nkh5/joint_effort/JointEffort-ROS2-V0/ros/docs/README.md

# Project notes

- [Setup](SETUP.md): install, build, and start the workspace.
- [Code](CODE.md): extra info.
- [Files](FILES.md): every file included in the folder. 

The [iron-arm guide](../iron_prototype/README.md) has the movement commands.
