nkh5/joint_effort/CAD/Gearboxes/Cycloidal/20-1 Micro Cycloidal BOM.csv

Part Name | Part URL | Part Cost (Per Unit) | Units Required | Required Part Total | Cost Per Pack
30*37*4mm Bearings | https://www.aliexpress.com/item/4000909605390.html | $2.64 | 2 | $5.28 | $13.20
7*13*4mm Bearings | https://www.aliexpress.com/item/1005004909186623.html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 | $2.02 | 2 | $4.04 | $20.19
8*12*3.5mm Bearings | https://www.aliexpress.com/item/1005006896182452.html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 | $1.03 | 2 | $2.06 | $10.30
M3*20mm Button Head Bolts | https://www.aliexpress.com/item/1005008064515476.html?curPageLogUid=Z8iONcXzmQOj | $0.11 | 6 | $0.64 | $2.12
M3*8mm Countersunk Bolts | https://www.aliexpress.com/item/1005006468976904.html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 | $0.05 | 4 | $0.18 | $2.25
M3 Nuts | https://www.aliexpress.com/item/1005007694230467.html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 | $0.05 | 6 | $0.28 | $2.36
M3*5mm*10mm Aluminium Rollers | https://www.aliexpress.com/item/1005005962614409.html | $0.23 | 6 | $1.41 | $4.69
 |  |  | Total Parts | Required Costs | Package Costs: (Makes 2+ Drives)
 |  |  | 28 | $13.88 | $55.11
