nkh5/joint_effort/CAD/Gearboxes/Harmonic/26-1 Micro Harmonic BOM.csv

Part Name | Part URL | Part Cost (Per Unit) | Units Required | Required Part Total | Cost Per Pack
30*37*4mm Bearings 2RS | https://www.aliexpress.com/item/4000909605390.html | $2.64 | 2 | $5.28 | $13.20
7*13*4mm Bearings 2RS | https://www.aliexpress.com/item/1005004909186623.html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 | $2.02 | 2 | $4.04 | $20.19
M3*12mm Countersunk Bolts | https://www.aliexpress.com/item/1005006468976904.html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 | $0.05 | 4 | $0.20 | $2.46
5mm Balls | https://www.aliexpress.com/item/1005005656499702.html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 | $0.04 | 14 | $0.56 | $2.01
M3*4.5mm*6mm (OD*Length) | https://www.aliexpress.com/item/1005003582355741.html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 | $0.11 | 6 | $0.65 | $3.23
 |  |  | Total Parts | Required Costs | Package Costs: (Makes 2+ Drives)
 |  |  | 28 | $10.72 | $41.09
