nkh5/joint_effort/CAD/Gearboxes/Cycloidal/Print-Ready Orientation/Flex Spline 0.05mm.stl

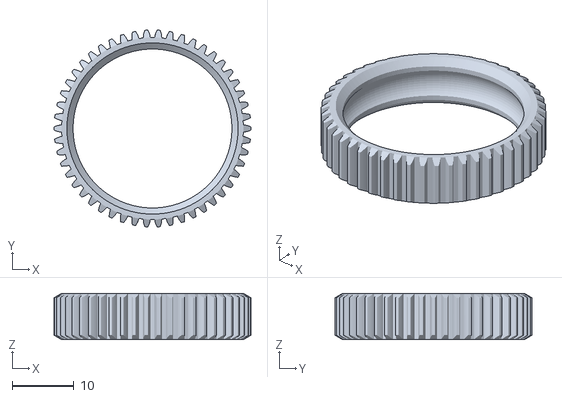
[picture p1: CAD file, 2026-11-12]
CAD/Gearboxes/Cycloidal/Print-Ready Orientation/Flex Spline 0.05mm.stl
32.0 x 32.0 x 7.50
