nkh5/joint_effort/JointEffort-Physical-Tests/ros2_ws/src/joint_effort_iron/meshes/base_rotation_link_hull.stl

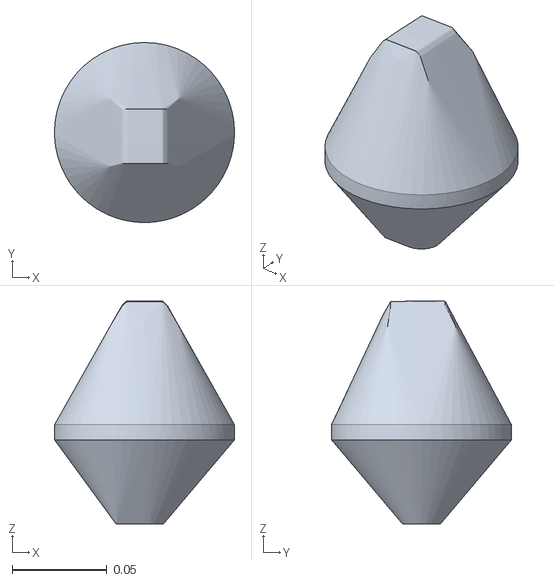
[picture p2: CAD file, 2026-10-19]
JointEffort-Physical-Tests/ros2_ws/src/joint_effort_iron/meshes/base_rotation_link_hull.stl
0.095 x 0.095 x 0.118
