nkh5/joint_effort/JointEffort-ROS2-V0/ros/ros2_ws/src/joint_effort_arm_draft_description/meshes/base_rotation_link.stl

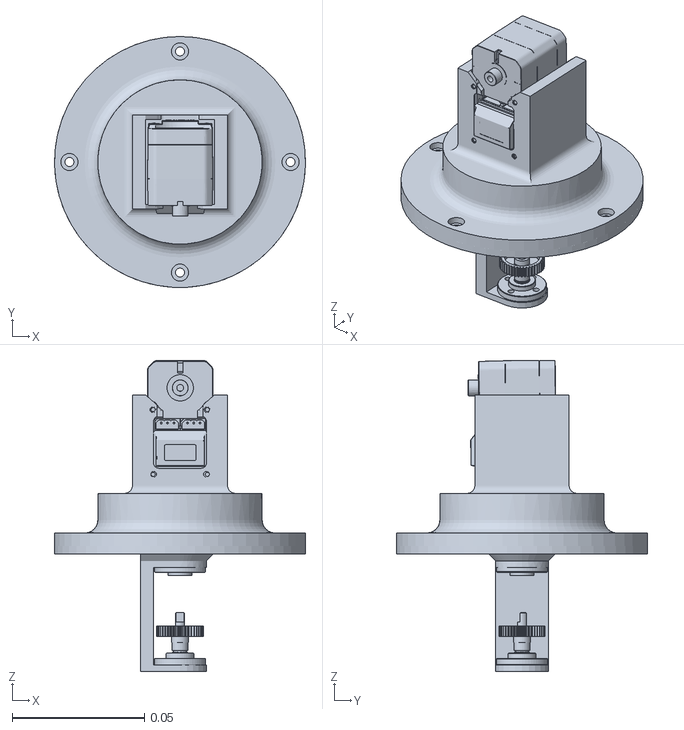
[picture p3: CAD file, 2026-10-17]
JointEffort-ROS2-V0/ros/ros2_ws/src/joint_effort_arm_draft_description/meshes/base_rotation_link.stl
0.095 x 0.095 x 0.118
