nkh5/joint_effort/JointEffort-ROS2-V0/ros/ros2_ws/src/joint_effort_iron/meshes/upper_arm_link_hull.stl

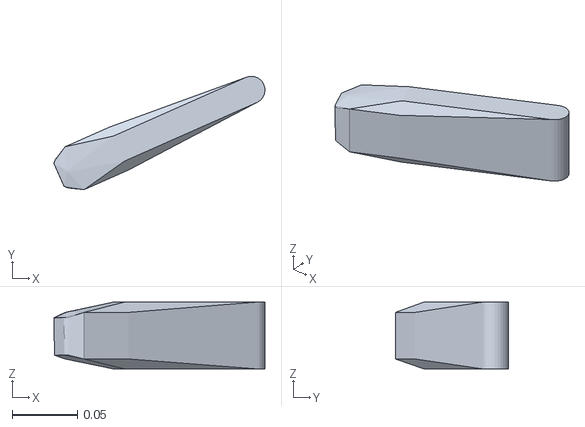
[picture p4: CAD file, 2026-10-17]
JointEffort-ROS2-V0/ros/ros2_ws/src/joint_effort_iron/meshes/upper_arm_link_hull.stl
0.162 x 0.087 x 0.0512
