nkh5/joint_effort/CAD/Gearboxes/Harmonic/Print-Ready Orientation/Flex Spline 0.15mm.stl

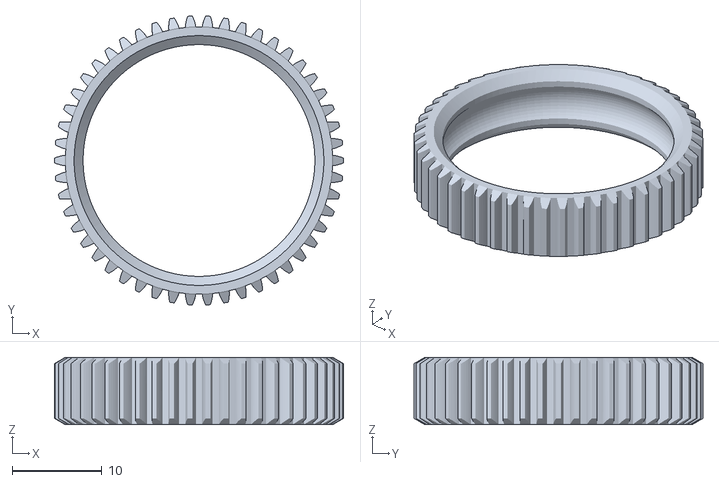
[picture p5: CAD file, 2026-11-12]
CAD/Gearboxes/Harmonic/Print-Ready Orientation/Flex Spline 0.15mm.stl
32.2 x 32.2 x 7.50
