nkh5/joint_effort/JointEffort-Physical-Tests/ros2_ws/src/joint_effort_iron/meshes/base_link_hull.stl

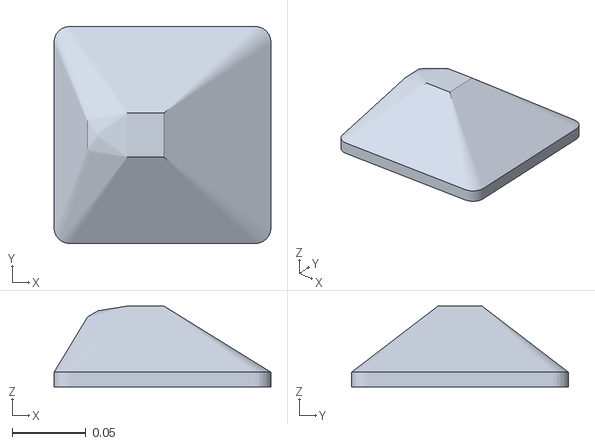
[picture p6: CAD file, 2026-10-19]
JointEffort-Physical-Tests/ros2_ws/src/joint_effort_iron/meshes/base_link_hull.stl
0.148 x 0.148 x 0.055
