nkh5/joint_effort/JointEffort-ROS2-V0/ros/ros2_ws/src/joint_effort_arm_draft_description/meshes/base_link.stl

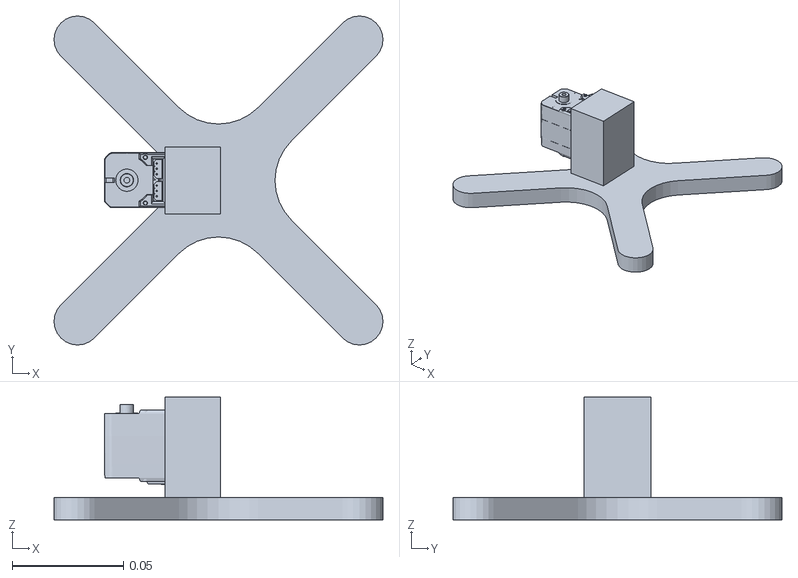
[picture p7: CAD file, 2026-10-17]
JointEffort-ROS2-V0/ros/ros2_ws/src/joint_effort_arm_draft_description/meshes/base_link.stl
0.148 x 0.148 x 0.055
