nkh5/joint_effort/CAD/Gearboxes/Harmonic/Print-Ready Orientation/Output.stl

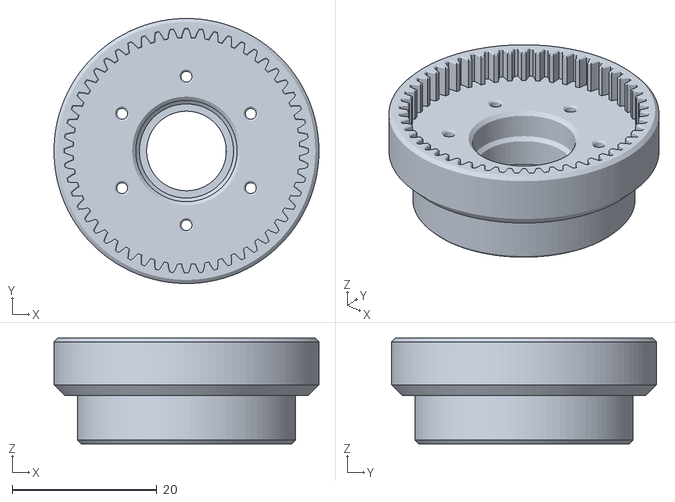
[picture p8: CAD file, 2026-11-12]
CAD/Gearboxes/Harmonic/Print-Ready Orientation/Output.stl
36.6 x 36.6 x 14.6
