nkh5/joint_effort/JointEffort-Physical-Tests/ros2_ws/src/joint_effort_iron/meshes/tool_link_hull.stl

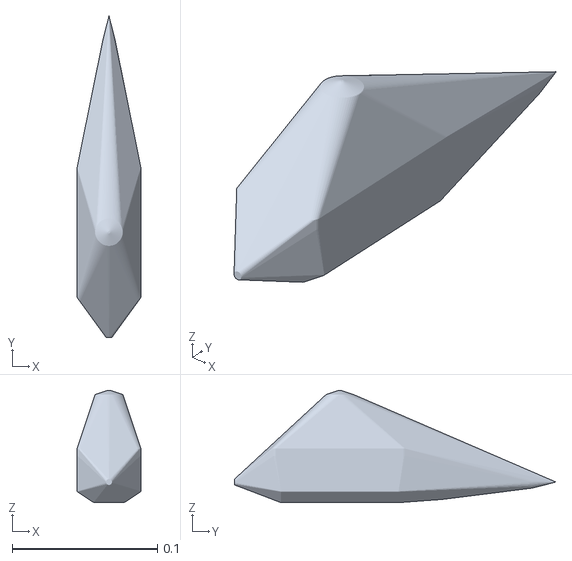
[picture p9: CAD file, 2026-10-19]
JointEffort-Physical-Tests/ros2_ws/src/joint_effort_iron/meshes/tool_link_hull.stl
0.044 x 0.221 x 0.0773
