nkh5/joint_effort/JointEffort-ROS2-V0/ros/ros2_ws/src/joint_effort_arm_draft_description/meshes/forearm_link.stl

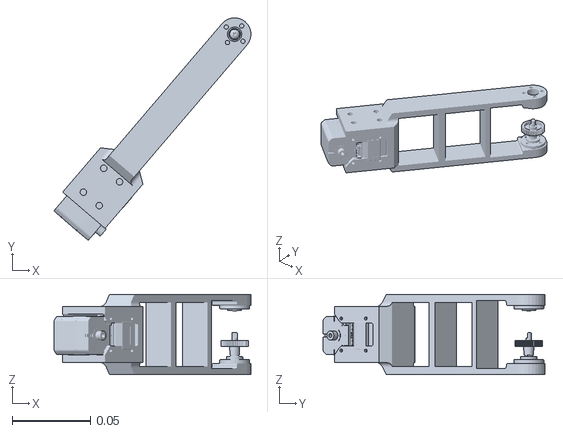
[picture p11: CAD file, 2026-10-17]
JointEffort-ROS2-V0/ros/ros2_ws/src/joint_effort_arm_draft_description/meshes/forearm_link.stl
0.126 x 0.142 x 0.0512
