nkh5/joint_effort/CAD/Gearboxes/Harmonic/Print-Ready Orientation/Shaft.stl

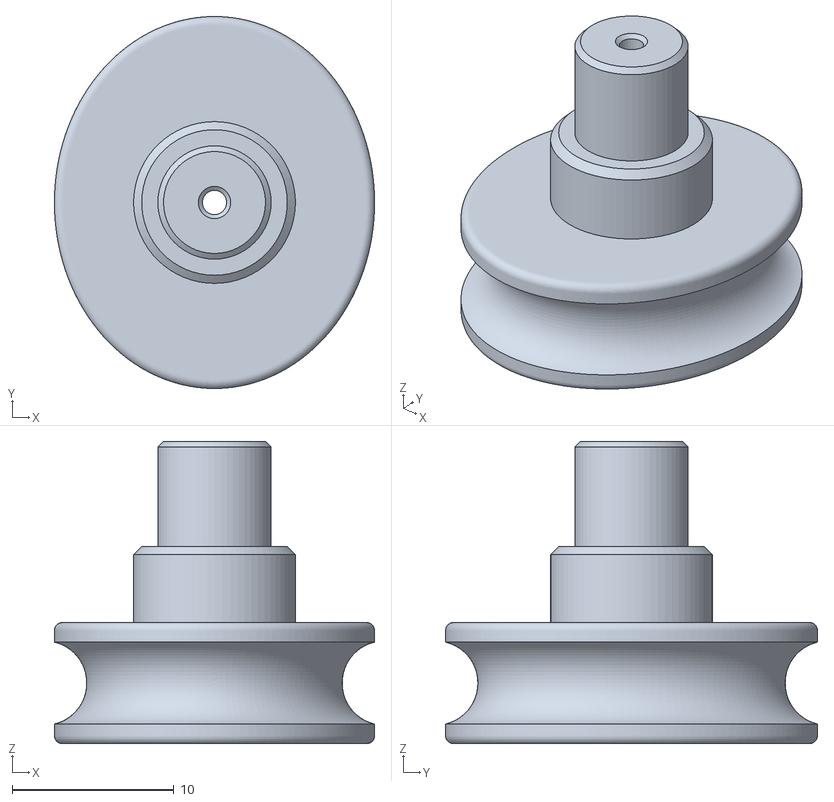
[picture p12: CAD file, 2026-11-12]
CAD/Gearboxes/Harmonic/Print-Ready Orientation/Shaft.stl
19.8 x 23.0 x 18.7
