nkh5/joint_effort/CAD/Gearboxes/Harmonic/Print-Ready Orientation/Housing.stl

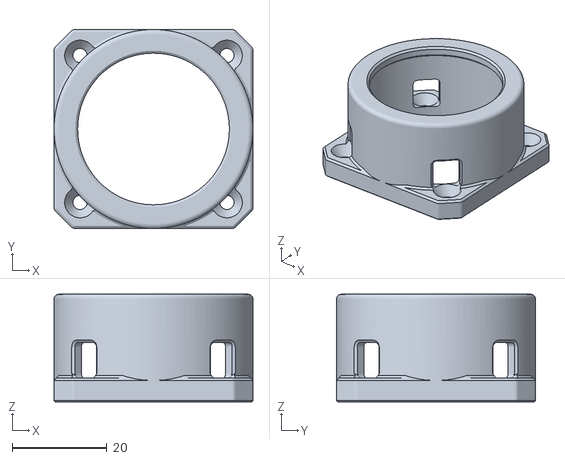
[picture p13: CAD file, 2026-11-12]
CAD/Gearboxes/Harmonic/Print-Ready Orientation/Housing.stl
42.0 x 42.0 x 22.7
