nkh5/joint_effort/CAD/Gearboxes/Harmonic/Print-Ready Orientation/Base - Nema 17.stl

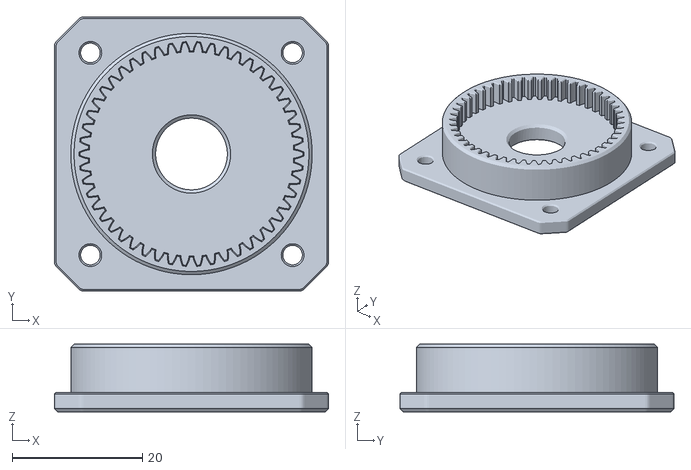
[picture p14: CAD file, 2026-11-12]
CAD/Gearboxes/Harmonic/Print-Ready Orientation/Base - Nema 17.stl
42.0 x 42.0 x 10.4
