nkh5/joint_effort/(list of files, cad)

Other CAD files:
CAD/Solder Extruder/Extruder Assembly.SLDASM
CAD/Solder Extruder/V2/Extruder Assembly_V2.SLDASM
CAD/V2.1/PSJv1.SLDASM
CAD/V2.1/joint stack arm v2/jointstack.SLDASM
CAD/V2.1/psj mechanism v2/PSJv2.SLDASM
CAD/Calibration/CalibrationAssembly.SLDASM
CAD/Solder Extruder/Guide Assembly.SLDASM
CAD/Solder Extruder/V2/Parts/Guide Assembly_V2.SLDASM
CAD/Calibration/Motor Holder.SLDPRT
CAD/Gearboxes/Harmonic/Print-Ready Orientation/Flex Spline 0.00mm.stl
CAD/Solder Extruder/Extruder Parts/Frame V1.2.SLDPRT
CAD/V2.1/psj mechanism v2/ToolHolderv2^PSJv2.SLDPRT
CAD/Calibration/Calibration Stick.SLDPRT
CAD/Gearboxes/Cycloidal/Print-Ready Orientation/Flex Spline 0.10mm.stl
CAD/Solder Extruder/Extruder Parts/Extruder Funnel V2.SLDPRT
CAD/Solder Extruder/Frame V1.1.SLDPRT
CAD/Solder Extruder/V2/Parts/Extruder Cover_V3.SLDPRT
CAD/Gearboxes/Cycloidal/Print-Ready Orientation/Flex Spline 0.25mm.stl
CAD/Solder Extruder/Extruder Parts/Stepper Motor 28BYJ-48.SLDPRT
CAD/Solder Extruder/Intake Funnel V2.SLDPRT
CAD/Solder Extruder/V2/Parts/Frame V1.2_V2.SLDPRT
CAD/V2.1/psj mechanism v2/editable_linkage2_bar1v1.SLDPRT
CAD/Gearboxes/Harmonic/Print-Ready Orientation/Flex Spline 0.20mm.stl
CAD/Solder Extruder/Extruder Funnel V2.SLDPRT
CAD/Solder Extruder/V2/Parts/Spring_V2.SLDPRT
CAD/V2.1/psj mechanism v2/editable_linkage2_bar2v1.SLDPRT
CAD/Solder Extruder/V2/Parts/Intake Funnel V2_V2.SLDPRT
CAD/V2.1/psj mechanism v2/editable_linkage3_bar2v1.SLDPRT
CAD/Solder Extruder/Extruder Guide Wheel.SLDPRT
CAD/Solder Extruder/V2/Parts/Extruder Gear_V2.SLDPRT
CAD/V2.1/psj mechanism v2/editable_linkage1_bar1v1.SLDPRT
CAD/V2.1/psj mechanism v2/editable_linkage3_bar1v1.SLDPRT
CAD/Solder Extruder/V2/Parts/Extruder Guide Frame_V2.SLDPRT
CAD/V2.1/psj mechanism v2/Solder_holder_clamp^PSJv2.SLDPRT
CAD/V2.1/psj mechanism v2/editable_linkage1_bar2v1.SLDPRT
CAD/V2.1/psj mechanism v2/editable_linkagev1.SLDPRT
CAD/Solder Extruder/Extruder Funnel.SLDPRT
CAD/Solder Extruder/V1/Extruder Assembly.SLDASM
CAD/Solder Extruder/V1/Extruder Parts/Extruder Funnel.SLDPRT
CAD/Solder Extruder/V1/Extruder Parts/Frame V1.1.SLDPRT
CAD/Solder Extruder/V1/Extruder Parts/Frame V1.2.SLDPRT
CAD/Solder Extruder/V2/Parts/Extruder Cover_V2.SLDPRT
CAD/V1.1/Base/Base Assembly V1.1.SLDASM
CAD/V1.1/Base/Base Motor Mount.SLDPRT
CAD/V1.1/Base/Base Rotating Part.SLDPRT
CAD/V1.1/Base/Fixed Base.SLDPRT
CAD/V1.1/Base/OLD Rotating Base.SLDPRT
CAD/V1.1/Base/Rotating Base.SLDPRT
CAD/V1.1/Elbow/Elbow Assembly V1.1.SLDASM
CAD/V1.1/Elbow/elbow joint.SLDASM
CAD/V1.1/Elbow/linkage_l1.SLDPRT
CAD/V1.1/Elbow/linkage_l2.SLDPRT
CAD/V1.1/Elbow/motormount_baseattachment.SLDPRT
CAD/V1.1/Full Assembly V1.1.SLDASM
CAD/V1.1/Iron Holder/Iron Holder Assembly V1.1.SLDASM
CAD/V1.1/Iron Holder/JE-ColdFit-Cap-R01.SLDPRT
CAD/V1.1/Iron Holder/JE-ColdFit-LowerSaddle-R01.SLDPRT
CAD/V1.1/Iron Holder/JE-ColdFit-Spine-R01.SLDPRT
CAD/V1.1/Wrist/Wrist Assembly V1.1.SLDASM
CAD/V1.1/Wrist/pitch_holder^wrist_v1.SLDPRT
CAD/V1.1/Wrist/yaw_mount^wrist_v1.SLDPRT
CAD/V1.2/R02-base_link.SLDPRT
CAD/V1.2/R02-base_rotation_link.SLDPRT
CAD/V1.2/R02-forearm_link.SLDPRT
CAD/V1.2/R02-tool_link.SLDPRT
CAD/V1.2/R02-upper_arm_link.SLDPRT
CAD/V1.2/R02-wrist_link.SLDPRT
CAD/V2.1/joint stack arm v2/8920N27_Light Duty Dry-Running Thrust Bearing.SLDPRT
CAD/V2.1/joint stack arm v2/92000A326_Passivated 18-8 Stainless Steel Pan Head Phillips Screws.SLDPRT
CAD/V2.1/psj mechanism v1/Linkage1^PSJv1.SLDPRT
CAD/V2.1/psj mechanism v1/Linkage1bar1v2^PSJv1.SLDPRT
CAD/V2.1/psj mechanism v1/Linkage1bar2v2^PSJv1.SLDPRT
CAD/V2.1/psj mechanism v1/Linkage2bar1v1^PSJv1.SLDPRT
CAD/V2.1/psj mechanism v1/Linkage2bar2v1^PSJv1.SLDPRT
CAD/V2.1/psj mechanism v1/Linkage2v2^PSJv1.SLDPRT
CAD/V2.1/psj mechanism v1/Linkage3bar1v1^PSJv1.SLDPRT
CAD/V2.1/psj mechanism v1/Linkage3bar2v1^PSJv1.SLDPRT
CAD/V2.1/psj mechanism v1/PSJv1.SLDASM
