nkh5/joint_effort/CAD/Gearboxes/Cycloidal/20-1 Micro Cycloidal Instructions.pdf

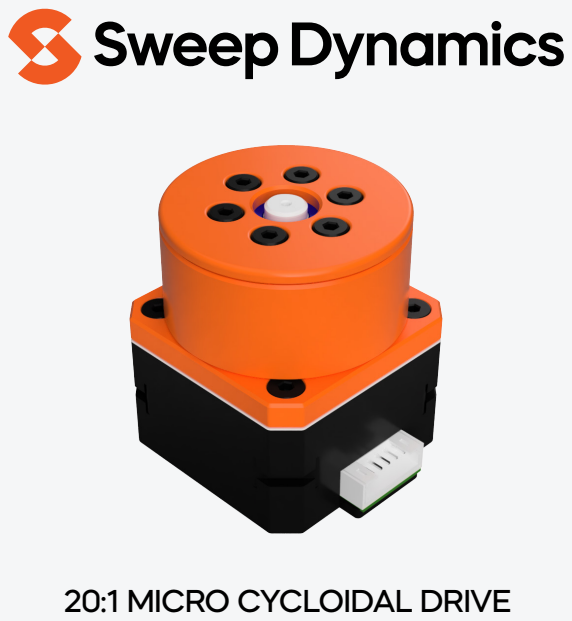
[picture p15: page 1]

20:1 MICRO CYCLOIDAL DRIVE

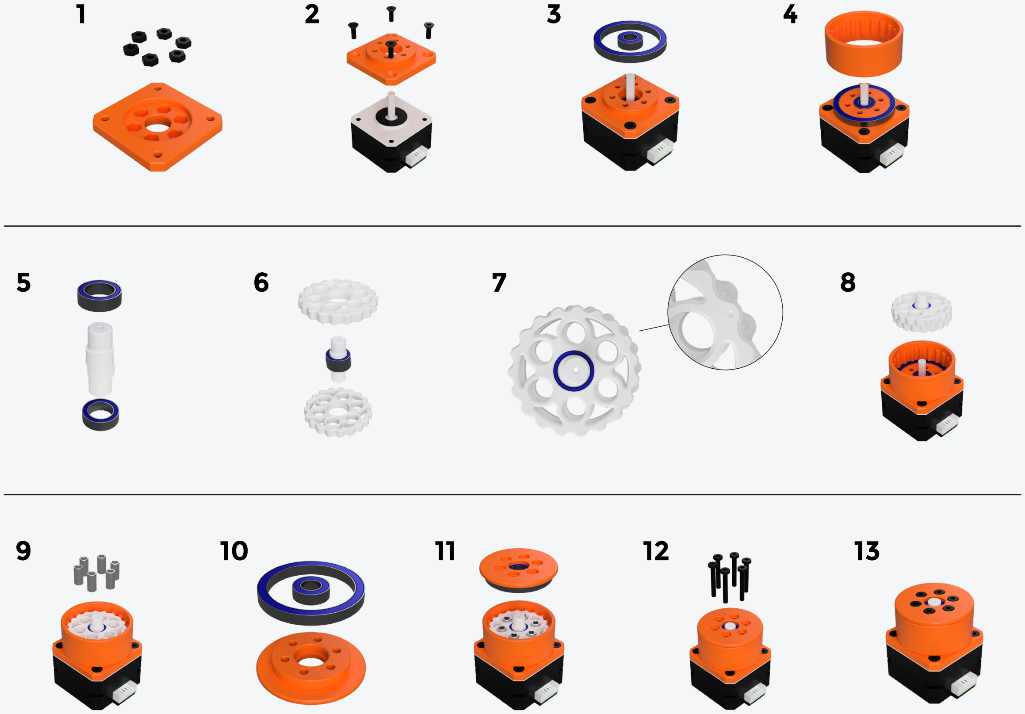
[picture p16: page 2]

1 | 2 | 3 | 4

5

9 | 10 | 11 | 12 | 13
6 | 7 | 8
