nkh5/joint_effort/CAD/Gearboxes/Harmonic/26-1 Micro Harmonic Instructions.pdf

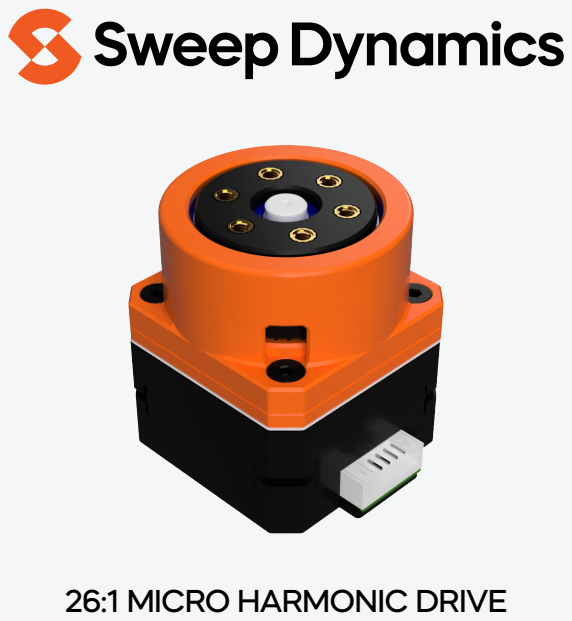
[picture p17: page 1]

26:1 MICRO HARMONIC DRIVE

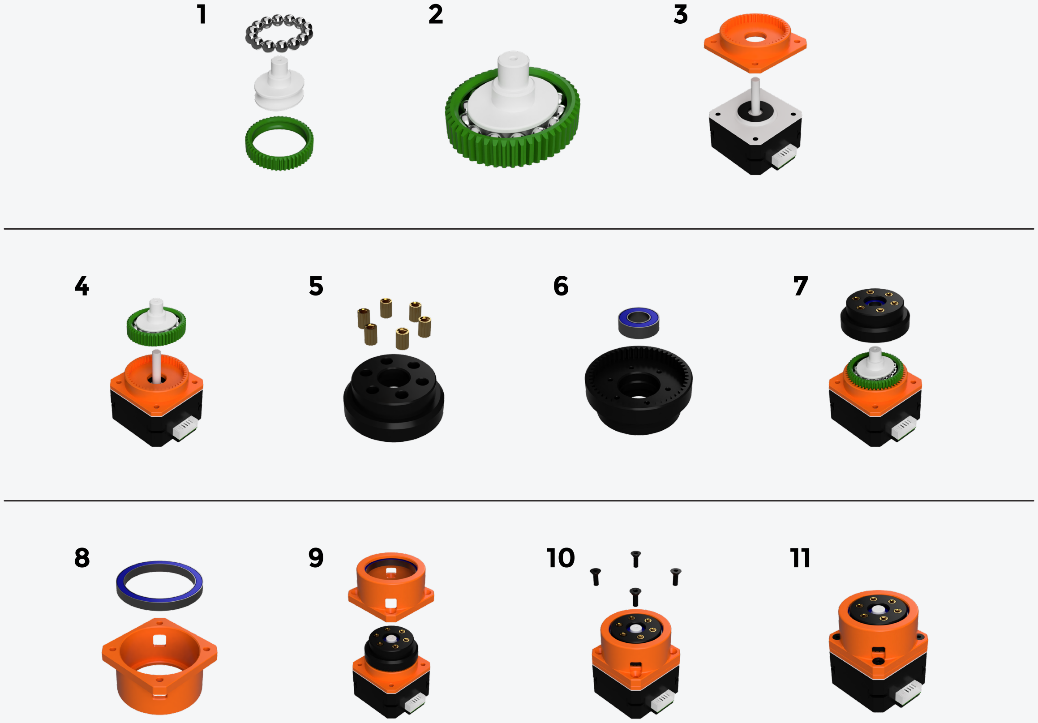
[picture p18: page 2]

1 | 2 | 3

4 5

9 | 10 | 11

6 7

8
