nkh5/joint_effort/(commit log)

2026-10-06 1st iteration of pico controller code following tinyusb
2026-10-07 Create CAD
    Folder to commit CAD
2026-10-07 Add CAD Git LFS workflow
2026-10-07 CAD V1.1
    Uploaded the first full assembly of the arm
    [Base Assembly V1.1.SLDASM, Elbow Assembly V1.1.SLDASM, Fixed Base.SLDPRT, Full Assembly V1.1.SLDASM, Iron Holder Assembly V1.1.SLDASM, JE-ColdFit-Cap-R01.SLDPRT, JE-ColdFit-LowerSaddle-R01.SLDPRT, JE-ColdFit-Spine-R01.SLDPRT]
2026-10-08 editing pitch holder
    [pitch_holder^wrist_v1.SLDPRT]
2026-10-08 yaw mount edit
    [yaw_mount^wrist_v1.SLDPRT]
2026-10-15 updated shoulder
    updated shoulder base to prevent bolt interference
2026-10-17 removed uncessary holes
2026-10-19 Add physical arm motor tests
2026-10-19 Permanent id and 3 motors
2026-10-20 Create Frame V1.1.SLDPRT
2026-10-23 Create Stepper Motor 28BYJ-48.SLDPRT
2026-10-23 updated extruder mechanism
2026-10-23 Worked on extrusion
2026-10-24 Add interactive MATLAB function for 3-RRR mechanism
    This file implements an interactive MATLAB function for a nominal spherical 3-RRR mechanism, allowing users to visualize and manipulate the mechanism's configuration through sliders for pitch, yaw, and roll.
2026-10-24 added v2.1 prelim joint stack
2026-10-24 Lots of updates to extruder assembly
2026-10-27 made calibration and worked extruder
2026-10-27 updated extruder
2026-10-27 linkage mechanism (no bearings)
2026-10-27 bearing holes added
    top part isn't flat, so need to fix linkages still
2026-10-28 Update Extruder Assembly.SLDASM
2026-10-28 updated extruder funnel
2026-10-28 created new extruder base plate to tweak tension
2026-11-03 Update Frame V1.2.SLDPRT
2026-11-05 fix hole sizes for linkage
    Pepper make me sad
2026-11-05 Add aligned arm CAD under CAD/V1.2 with edited README
2026-11-08 started v2 for extruder
2026-11-08 progress on V2 of extruder mechanism
2026-11-08 made extruder cover
2026-11-09 more extruder stuff
2026-11-09 more work on the extruder
2026-11-09 extruder mechansim
2026-11-12 added gearbox files
2026-11-12 added missing gearbox files
